ForgeMotion/Electronics/SF Electronics V1.1.jpg

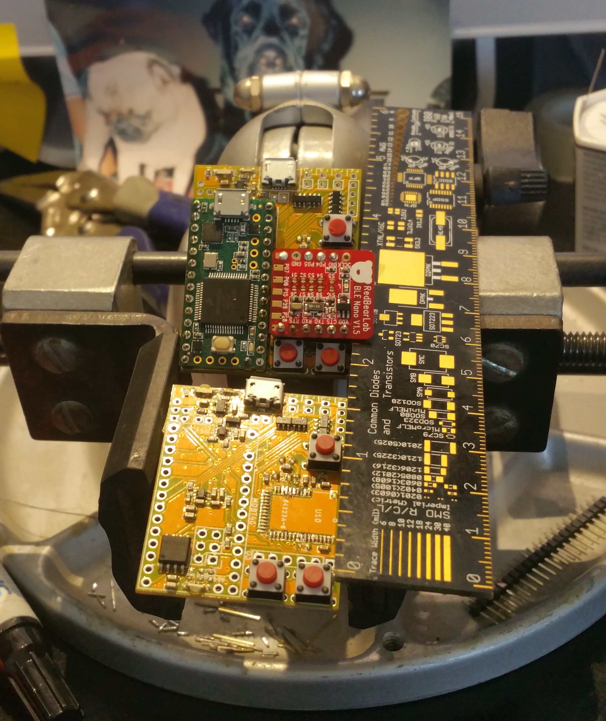
SF Electronics V1.1.jpg
