ForgeMotion/Electronics/SF Electronics V1.1 vs Mega.jpg

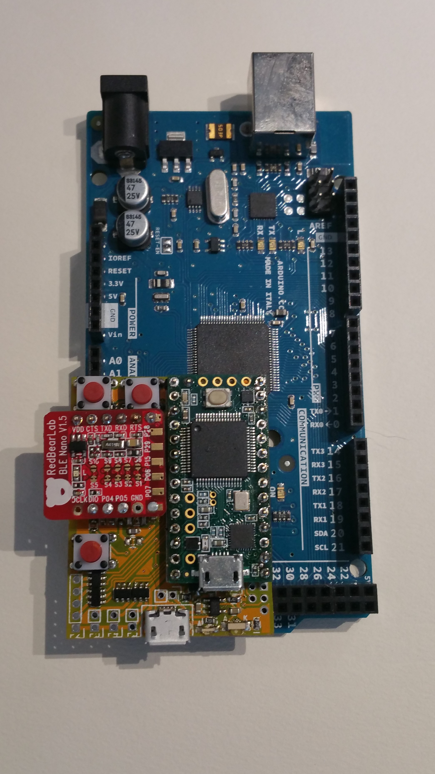
SF Electronics V1.1 vs Mega.jpg
