ForgeMotion/Electronics/Mainboard/Swing Forge V2 Mainboard.png

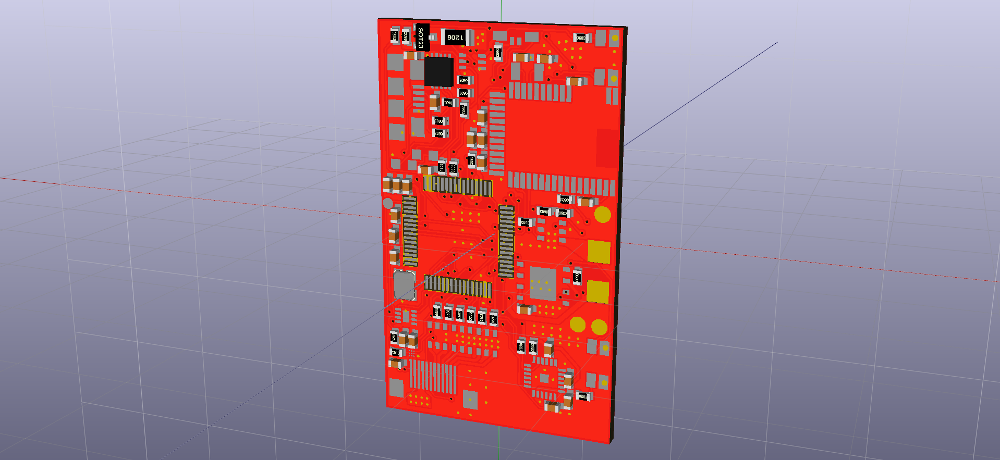
Mainboard/Swing Forge V2 Mainboard.png
