ForgeMotion/Electronics/Reference/BLE Nano Pinout Numbered.png

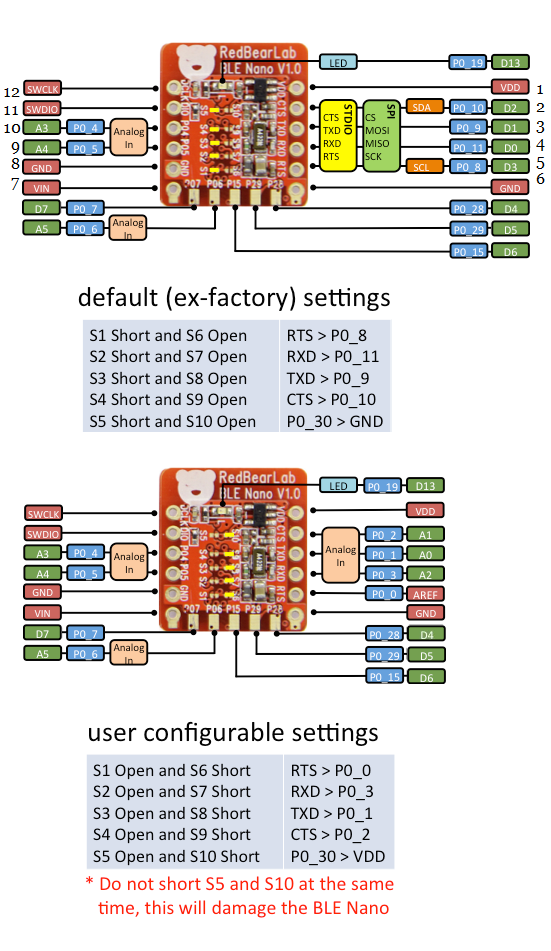
Reference/BLE Nano Pinout Numbered.png
