ForgeMotion/Electronics/Reference/Redbear pinout consolidated.jpg

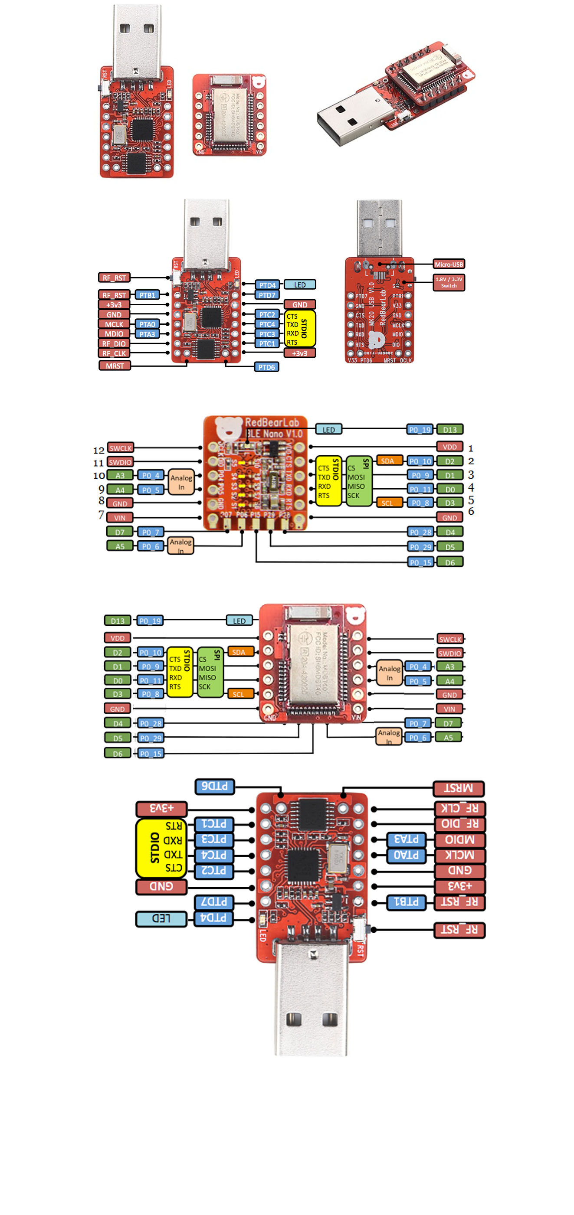
Reference/Redbear pinout consolidated.jpg
