ForgeMotion/Electronics/Reference/Soft latch power switch toggle.PNG

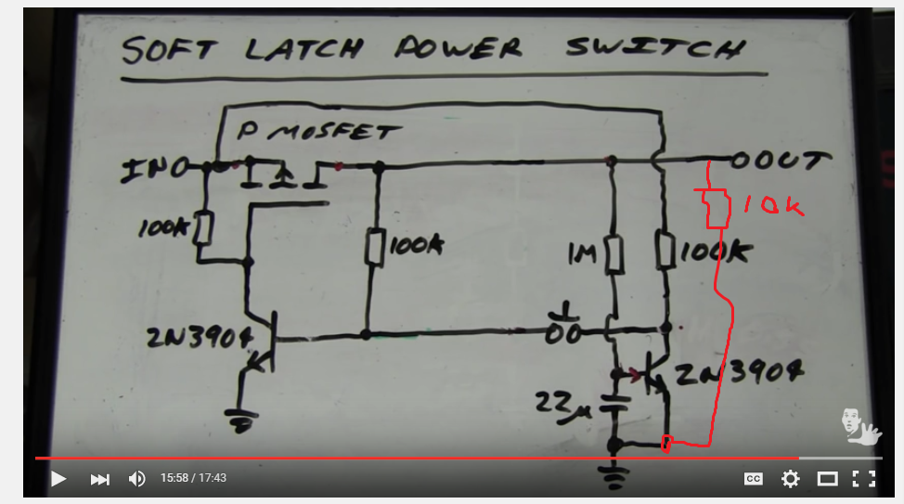
Reference/Soft latch power switch toggle.PNG
