ForgeMotion/Electronics/SF Electronics V1.1 no proc annotated.jpg

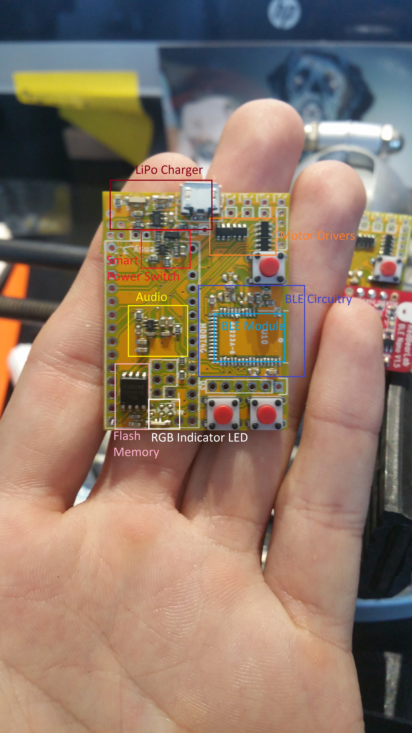
SF Electronics V1.1 no proc annotated.jpg
