ForgeMotion/Electronics/BOM estimation.xlsx

Number of boards | Reference | Description | Quantity per board | Order Quantity | Footprint | Mfg Name | Mfg Part Number | Mouser Part Number | Suggested Replacement | Price 1 | Min\Mult Order Qty | Line price | Line price per board
1000 | U7 | BLE 4.1 Module NRF51822 | 1 | 1000 | MDBT40:MDBT40 | Raytac | MDBT40 |  |  | $7.50 |  | $7500.00 | $7.50
 | U1 | ARM Microcontrollers - MCU ARM Microcontrollers - MCU KINETIS 256K | 1 | 1000 | MK20DX256VLH7:QFP50P1200X1200X160-64N | NXP | MK20DX256VLH7 | 841-MK20DX256VLH7 |  | $4.37 | 1\1 | $4370.00 | $4.37
 | U8 | MPU-6050 | 1 | 1000 | Sensors_Custom:MPU-6050_QFN-24 | Invensense | MPU-6050 | 1428-1007-1-ND |  | $4.05 |  | $4050.00 | $4.05
 | U2 | 128MB SPI Flash | 1 | 1000 | SparkFun-Sensors:SO08WIDE | Winbond Electronics | W25Q128FVSIG | W25Q128FVSIG-ND |  | $1.13 |  | $1130.97 | $1.13
 | U10 | MOSFET MOSFET 650mW 20V | 4 | 4000 | SOT_Custom:SOT-26 | Diodes Incorporated | DMN2215UDM-7 | 621-DMN2215UDM-7 |  | $0.174 | 1\1 | $696.00 | $0.70
 | U5 | Digital Potentiometer ICs Digital Potentiometer ICs Sgl 256-tap Volatile DigiPot w/SPI | 1 | 1000 | SparkFun-PowerIC:TDFN-8 | Maxim Integrated | MAX5395LATA+T | 700-MAX5395LATA+T |  | $0.648 | 1\1 | $648.00 | $0.65
 | SW1 | Tactile Switches Tactile Switches | 3 | 3000 | Switches_Custom:PTS840_PK_alt_2pin | C&K Components | PTS840 PK SMTR LFS | 611-PTS840PKSMTR |  | $0.17 | 1\1 | $510.00 | $0.51
 | P1 | FFC & FPC Connectors FFC & FPC Connectors ZIF FPC 0.5, 2H, 10P | 1 | 1000 | Connectors_Custom:TE_1-1775333-0_FPC_Socket_10pin | TE Connectivity | 1-1775333-0 | 571-1-1775333-0 |  | $0.48 | 20000\20000 | $480.00 | $0.48
 | U3 | Battery Management Battery Management Charge mgnt contr | 1 | 1000 | SparkFun-DigitalIC:SOT23-5 | Microchip | MCP73831T-2ACI/OT | 579-MCP73831T-2ACIOT |  | $0.42 | 1\1 | $420.00 | $0.42
 | P2 | USB Connectors USB Connectors uUSB B Rec BotMt Flangeless SMT | 1 | 1000 | open-project:MICRO-B_USB | Molex | 47346-1001 | 538-47346-1001 |  | $0.409 | 1\1 | $409.00 | $0.41
 | U6 | Audio Amplifiers Audio Amplifiers Speaker Amplifier | 1 | 1000 | Audio_Amplifiers_Custom:MAX38309 | Maxim Integrated | MAX98310EWL+T | 700-MAX98310EWL+T |  | $0.385 | 1\1 | $385.00 | $0.39
 | X2 | Crystals Crystals 32.768kHz AECQ200 9pF 20ppm -40cC +85C | 1 | 1000 | Crystal_Custom:ABS07AIG | ABRACON | ABS07AIG-32.768kHz-9-D-T | 815-S07AIG-32.7689DT |  | $0.339 | 1\1 | $339.00 | $0.34
 | X1 | Crystals 16MHz 10ppm 9pF -20C +75C | 1 | 1000 | Crystals:crystal_FA238-TSX3225 | Epson Timing | TSX-3225 16.0000MF09Z-AC3 | 732-TX325-16F09Z-AC3 |  | $0.27 |  | $272.00 | $0.27
 | Q1 | MOSFET MOSFET P-CHANNEL ENHANCEMENT MODE | 1 | 1000 | TO_SOT_Packages_SMD:SOT-23 | Diodes Incorporated | DMG3415U-7 | 621-DMG3415U-7 |  | $0.17 | 1\1 | $170.00 | $0.17
 | D1 | Standard LEDs - SMD Standard LEDs - SMD SMD LED Side Look Red/Green/Blue | 1 | 1000 | LEDS_SMD_Custom:LTST-S310 | Lite-On | LTST-S310F2KT | 859-LTST-S310F2KT |  | $0.168 | 1\1 | $168.00 | $0.17
 | U4 | LDO Voltage Regulators LDO Voltage Regulators FAST TRANSIENT RESPO | 1 | 1000 | Regulators_Custom:XDFN4_1x1mm_for_NCP177 | ON Semiconductor | NCP177AMX330TCG | 863-NCP177AMX330TCG |  | $0.104 | 1\1 | $104.00 | $0.10
 | L1 | Fixed Inductors Fixed Inductors 10uH 10% | 1 | 1000 | Capacitors_SMD:C_0603 | Vishay | 70-ILSB0603RK100K | 70-ILSB0603RK100K |  | $0.088 | 1\1 | $88.00 | $0.09
 | D2 | Standard LEDs - SMD Standard LEDs - SMD Red Clear 631nm | 1 | 1000 | LEDS_SMD_Custom:LTST-S270 | Lite-On | LTST-S270KRKT | 859-LTST-S270KRKT |  | $0.057 | 1\1 | $57.00 | $0.06
 | D3 | Standard LEDs - SMD Standard LEDs - SMD Green Clear 571nm | 1 | 1000 | LEDS_SMD_Custom:LTST-S270 | Lite-On | LTST-S270KGKT | 859-LTST-S270KGKT |  | $0.057 | 1\1 | $57.00 | $0.06
 | Q2 | Bipolar Transistors - BJT Bipolar Transistors - BJT 600mA 75V Dual NPN | 1 | 1000 | SOT_Custom:SOT-363 | ON Semiconductor | MBT2222ADW1T1G | 863-MBT2222ADW1T1G |  | $0.044 | 1\1 | $44.00 | $0.04
 | L2 | Fixed Inductors Fixed Inductors 15nH 10% | 1 | 1000 | Capacitors_SMD:C_0603 | Johanson | L-14C15NKV4T | 609-L-14C15NKV4T |  | $0.02 | 1\1 | $20.00 | $0.02
 | BT1 | 1S 1000mAh Lipo battery | 1 | 1000 | Pin_Headers_github:Pin_Header_Straight_1x02_Pitch2.00mm |  |  |  |  | $0.00 |  | $0.00 | $0.00
 |  |  |  |  |  |  |  |  |  |  |  | $21917.97
 |  |  |  |  |  |  |  |  |  |  |  | $21.92
 |  |  |  |  |  |  |  |  |  | Changes
 |  |  |  |  |  |  |  |  |  |  | Remove 1 switch | -0.17
 |  |  |  |  |  |  |  |  |  |  | 128MB->64MB flash | -0.60747
 |  |  |  |  |  |  |  |  |  |  | Get MDBT40 quote | -4
 |  |  |  |  |  |  |  |  |  |  | New audio | 0.1
 |  |  |  |  |  |  |  |  |  |  | Faster charging |  | 0.5
 |  |  |  |  |  |  |  |  |  |  | Remove BJT | -0.04
 |  |  |  |  |  |  |  |  |  |  | Internal LDO | -0.1
 |  |  |  |  |  |  |  |  |  |  | Ali MPU-6050 | -1.55
 |  |  |  |  |  |  |  |  |  |  | Ali Battery | -1
 |  |  |  |  |  |  |  |  |  |  | New USB conn |  | -0.2
 |  |  |  |  |  |  |  |  |  |  | New total | $14.55
