ForgeMotion/Electronics/Power consumption testing.xlsx

teensy | 18.5 | mA
audio | 3 | W
 | 909.0909091 | mA |  | Peak 3.3V current consumption
 |  |  |  | 116.4 | *Does not include audio! Run from battery and try to compensate for battery voltage with volume control!
rgb | 60 | mA |  | 349.2
motors | 7
 | 100 | mA
BLE
TX | 6 to 16 | mA | for -30 to +4 dBm
RX | 13 | mA
mpu6050
standby | 5 | uA
operating | 3.9 | mA
SPI flash
standby | 1 | uA
operating | 4 | mA |  | 400 | mAh
 |  |  |  | 1440000 | mAs
 |  |  | per swing | 30 | s
 |  |  | motors | 50% |  | of time
 |  |  |  | 10500 | mAs
 |  |  | mpu6050 | 117 | mAs
 |  |  | SPI flash | 120 | mAs
 |  |  | Audio | 1 | s
 |  |  |  | 810.8108108 | mAs
 |  |  |  | 11547.81081 | mAs | per swing
 |  |  | at boot
 |  |  | Audio | 20 | s
 |  |  |  | 16216.21622 | mAs
 |  |  | mpu6050 | 58.5 | mAs
 |  |  | motors | 30 | s
 |  |  |  | 21000 | mAs
 |  |  | BLE | 30 | s
 |  |  |  | 480 | mAs
 |  |  |  | 37754.71622 | mAs | per boot
 |  |  | idle power
 |  |  |  | 0.2 | mA
 |  |  | regular operation
 |  |  | 1 | boot
 |  |  | 90 | swings per hour
 |  |  | 900 | seconds of idle/hour
 |  | boot | 37754.71622 | mAs
 |  | idle/hour | 180 | mAs
 |  | swing/hour | 1039302.973 | mAs
 |  |  | 4 | hours
 |  |  | 4195686.608 | mAs
 |  |  | 1165.468502 | mAh
 |  |  | 1000 | mAh
 |  |  | 3600000 | mAs
 |  |  | 3.426939523 | hours
