ForgeMotion/Electronics/Red PCB 1 Testpoint locations.PNG

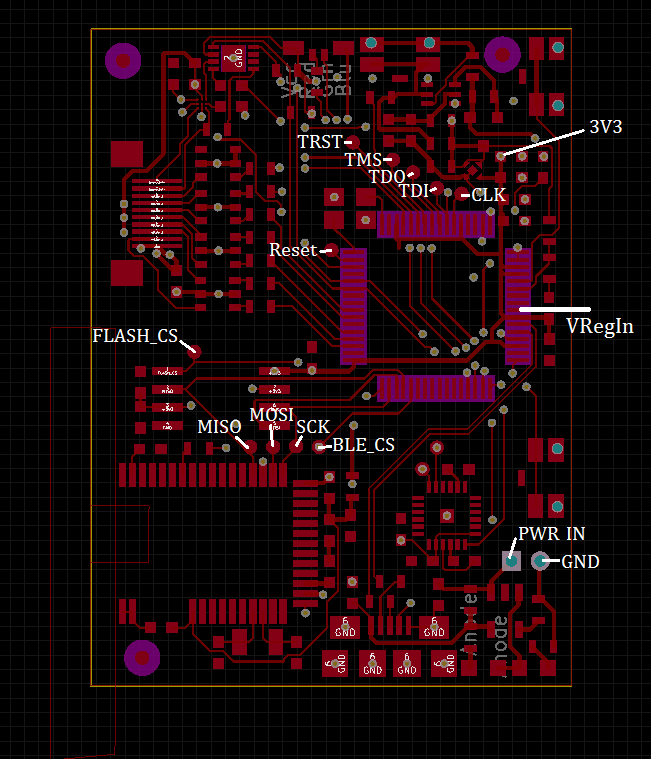
Red PCB 1 Testpoint locations.PNG
