ForgeMotion/Electronics/(threads)

Thread 3 (2018-01-09):

Move therm pin to reduce risk of shorts in production

TMcGahee, 2018-01-09:
