ForgeMotion/Electronics/Distroboard/Distroboard Schematic V1.0.pdf

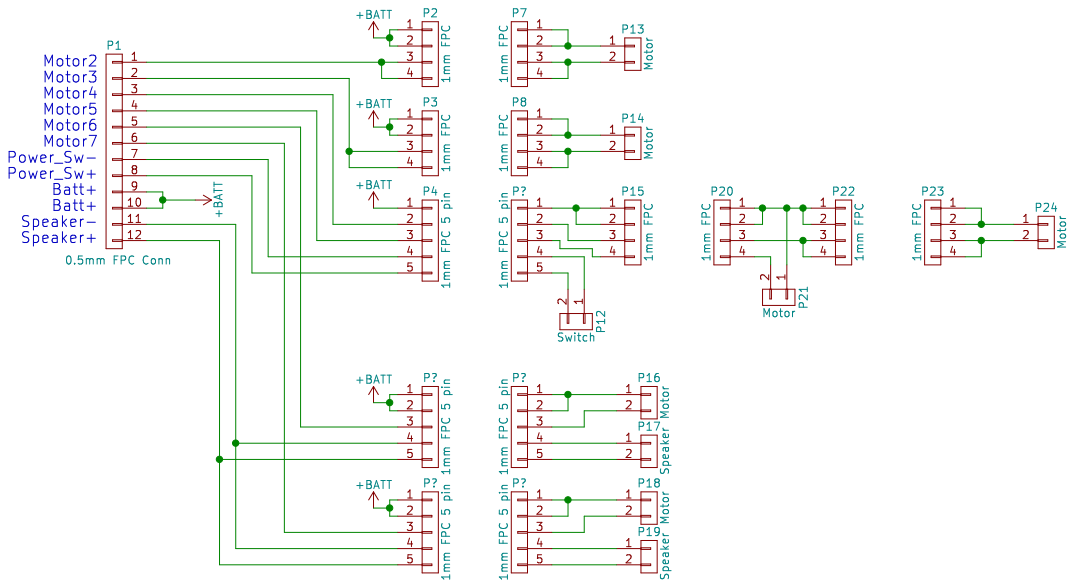
[picture p9: page 1]
