ForgeMotion/Electronics/Mainboard/Swing Forge Schematic 4.2.pdf

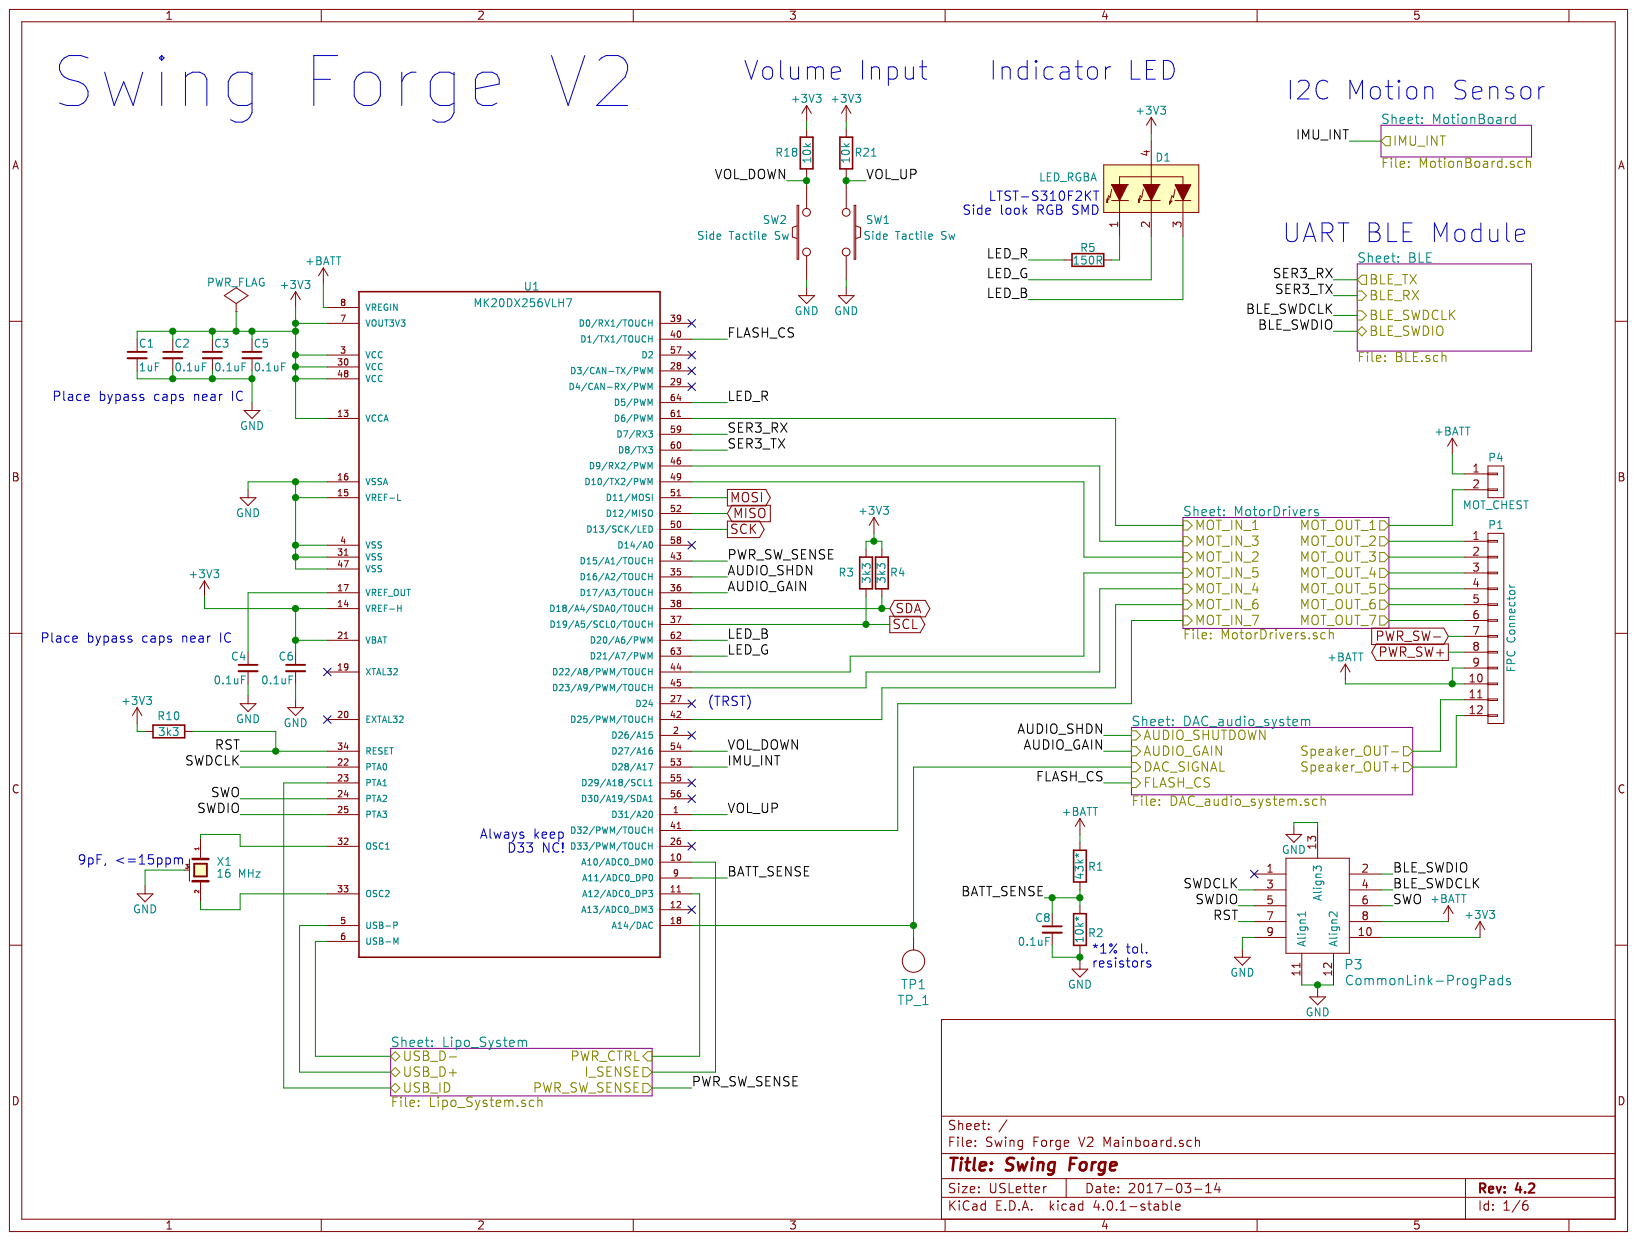
[picture p10: page 1]

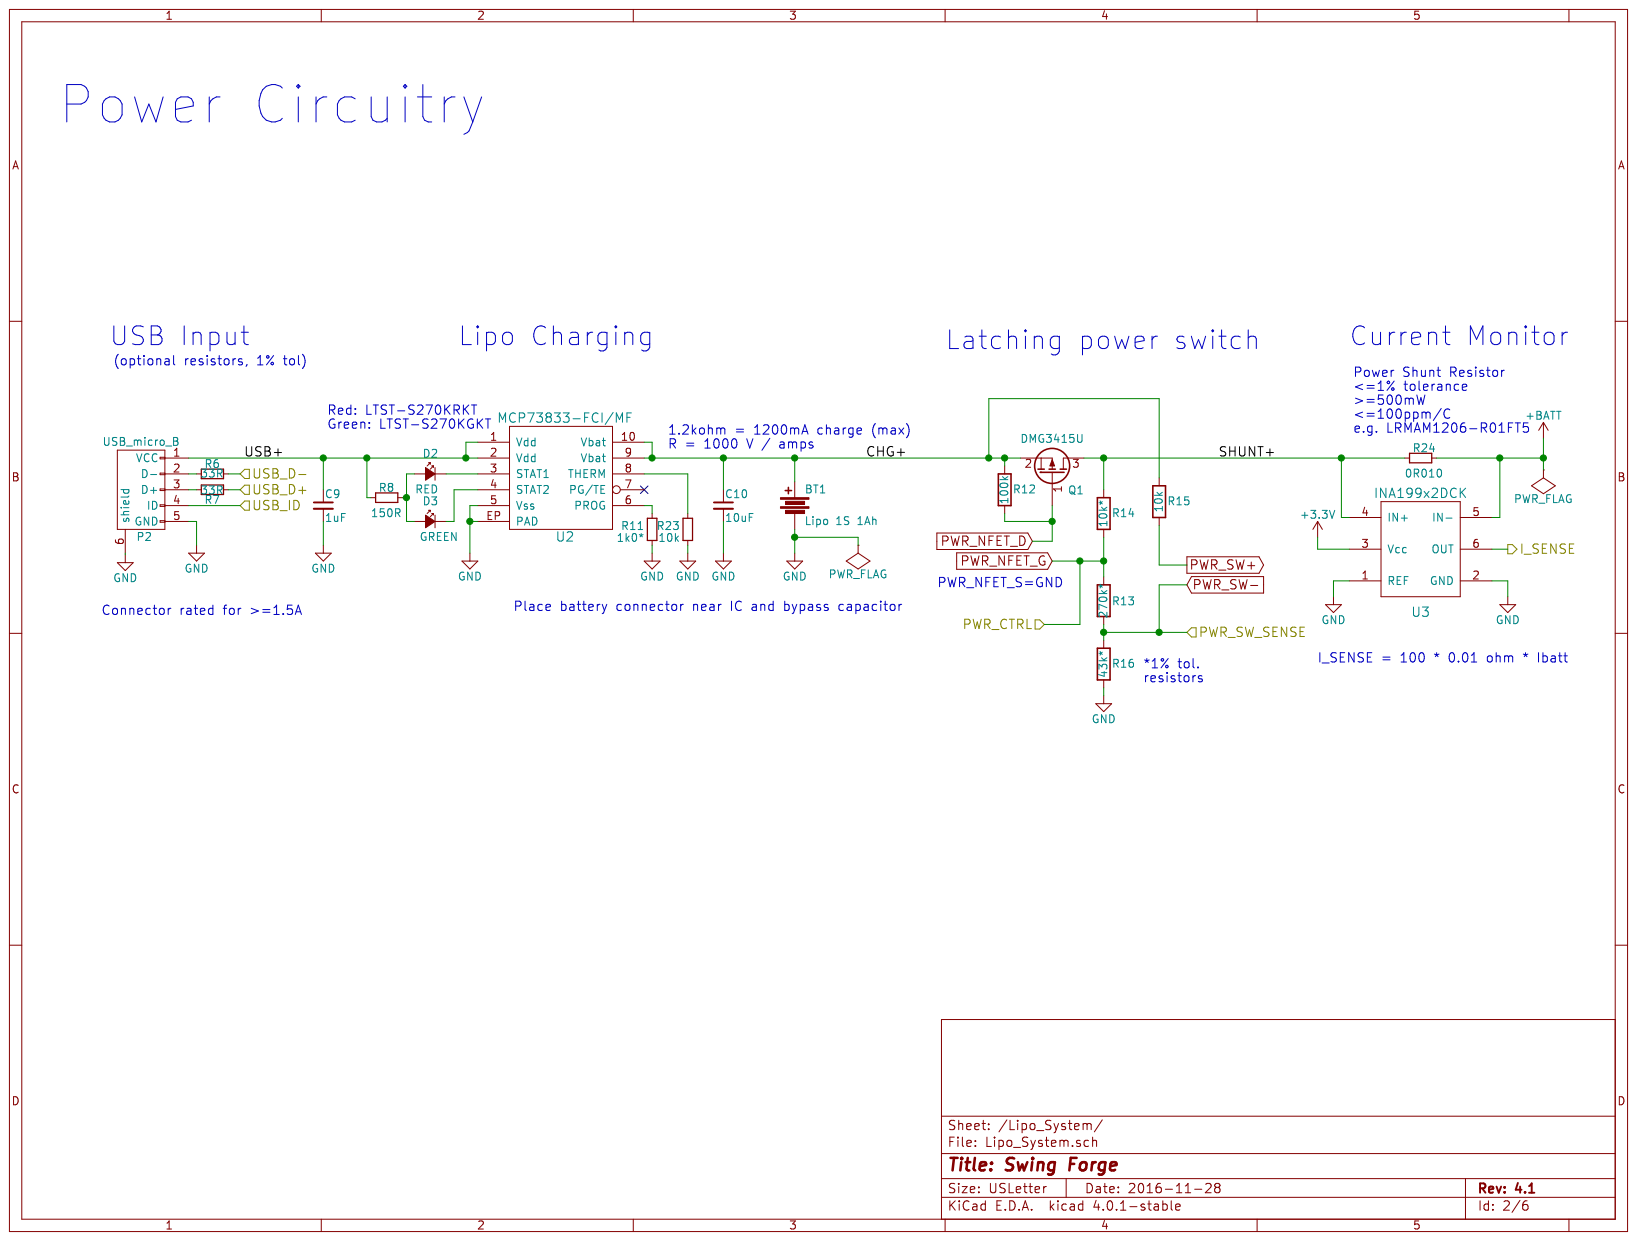
[picture p11: page 2]

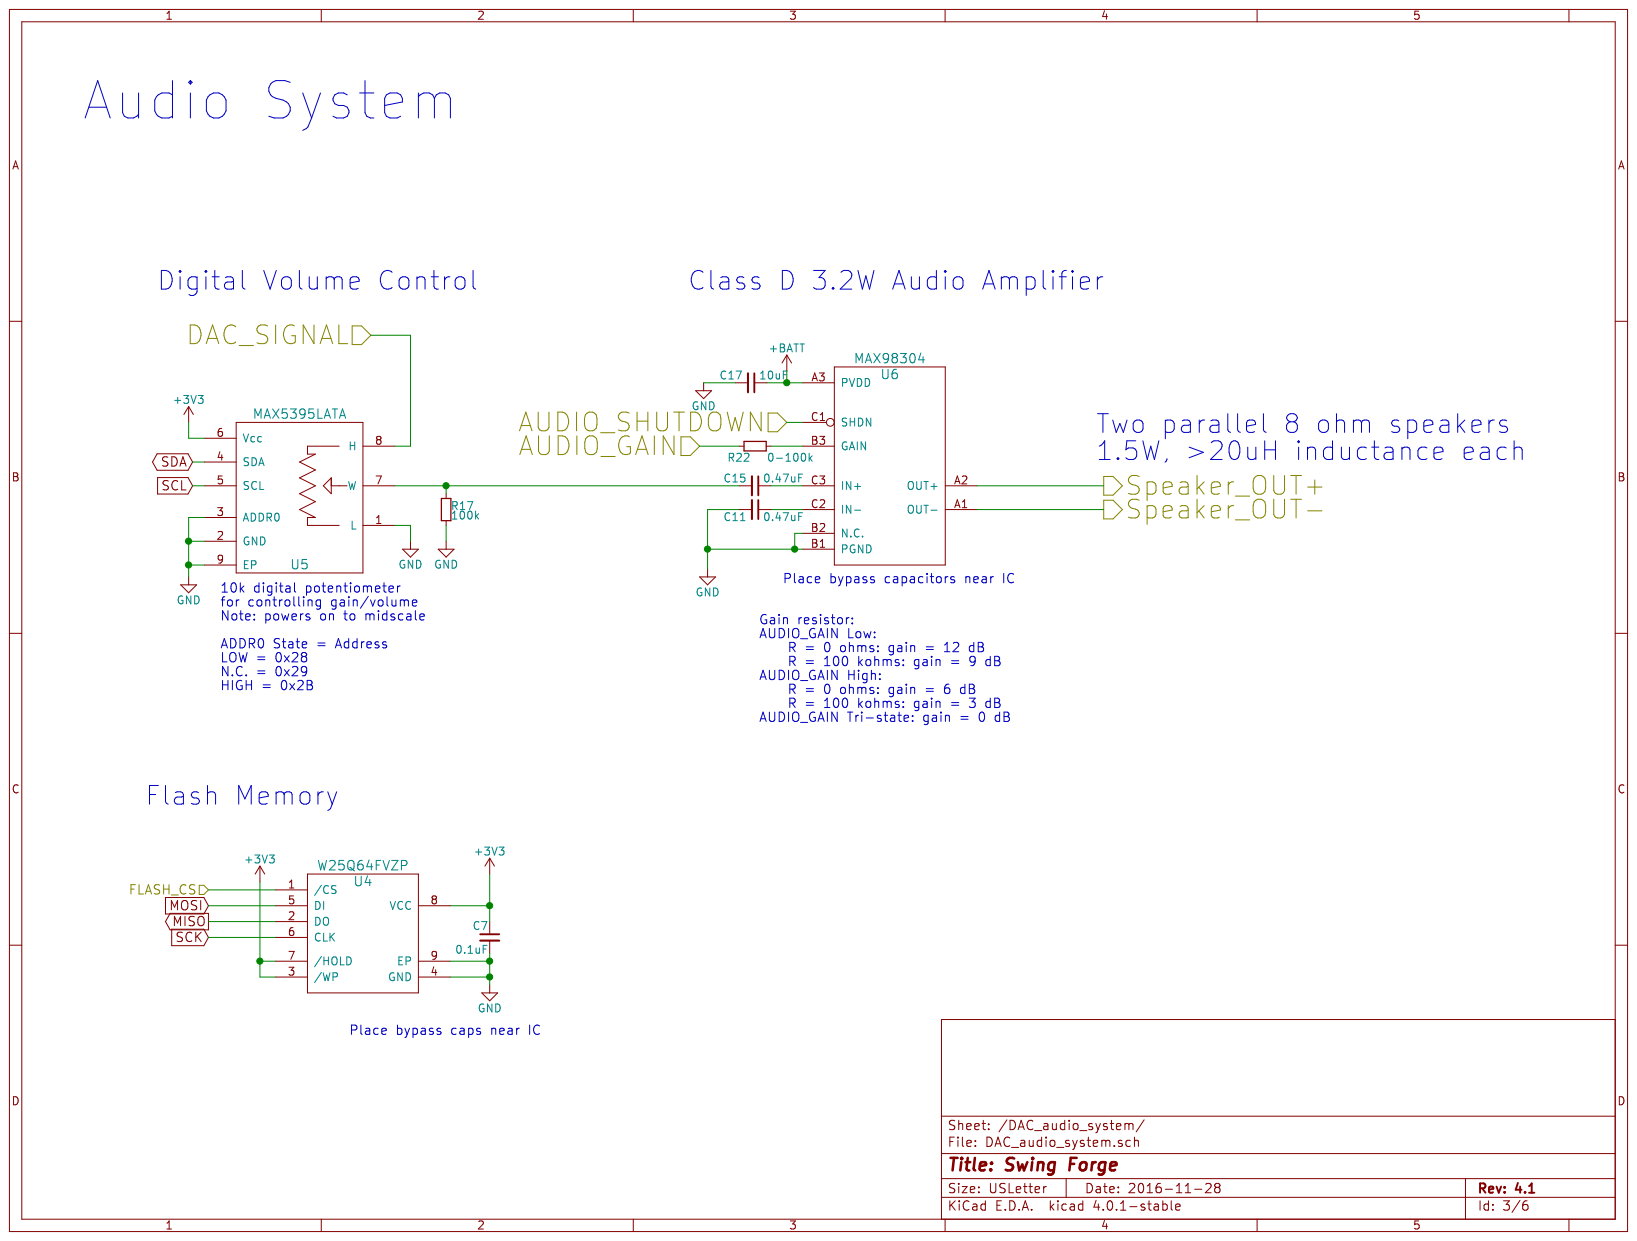
[picture p12: page 3]

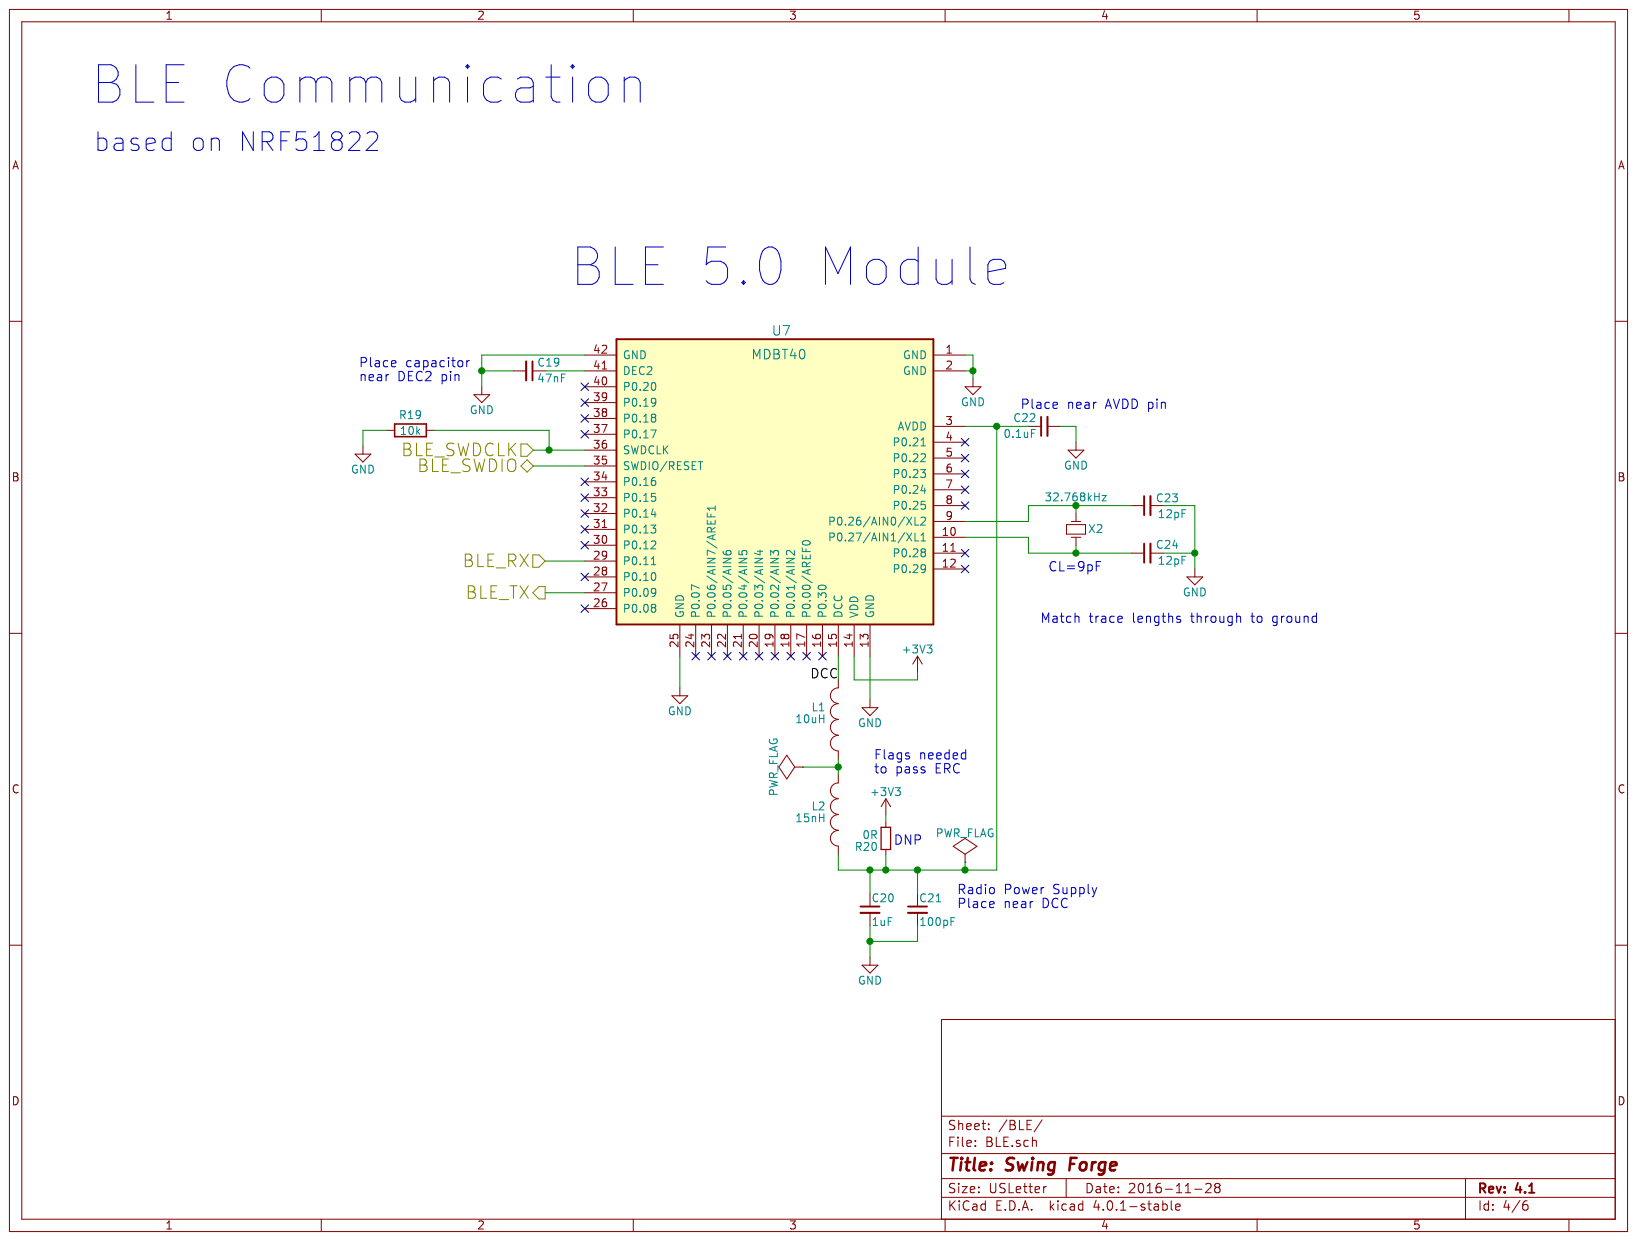
[picture p13: page 4]

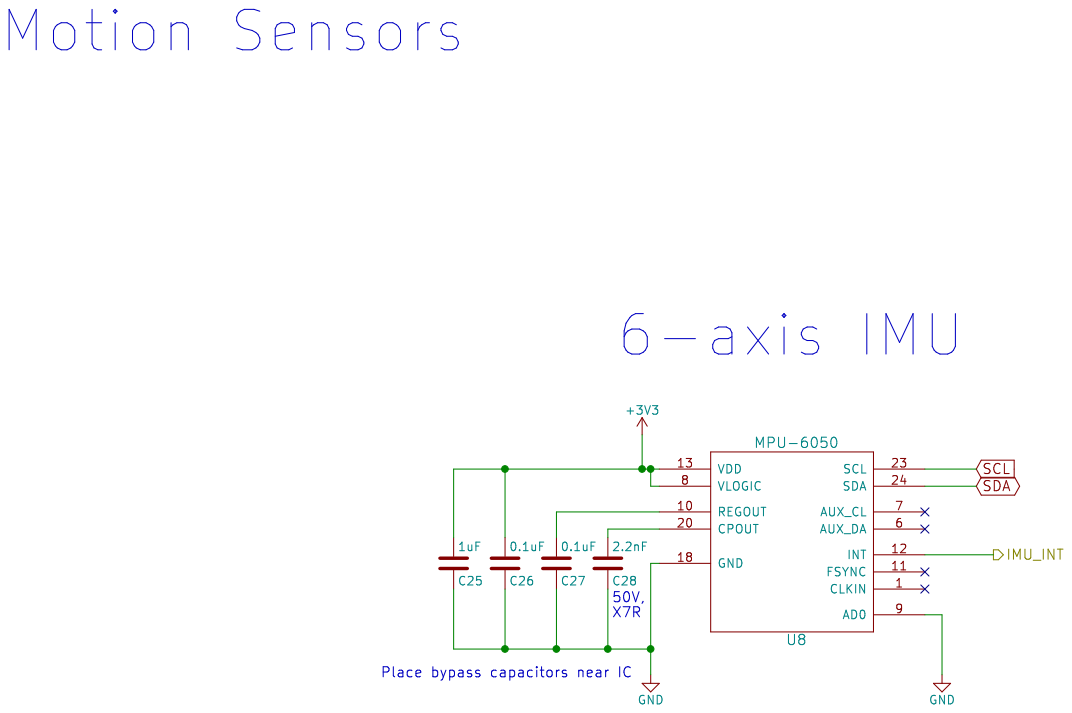
[picture p14: page 5]

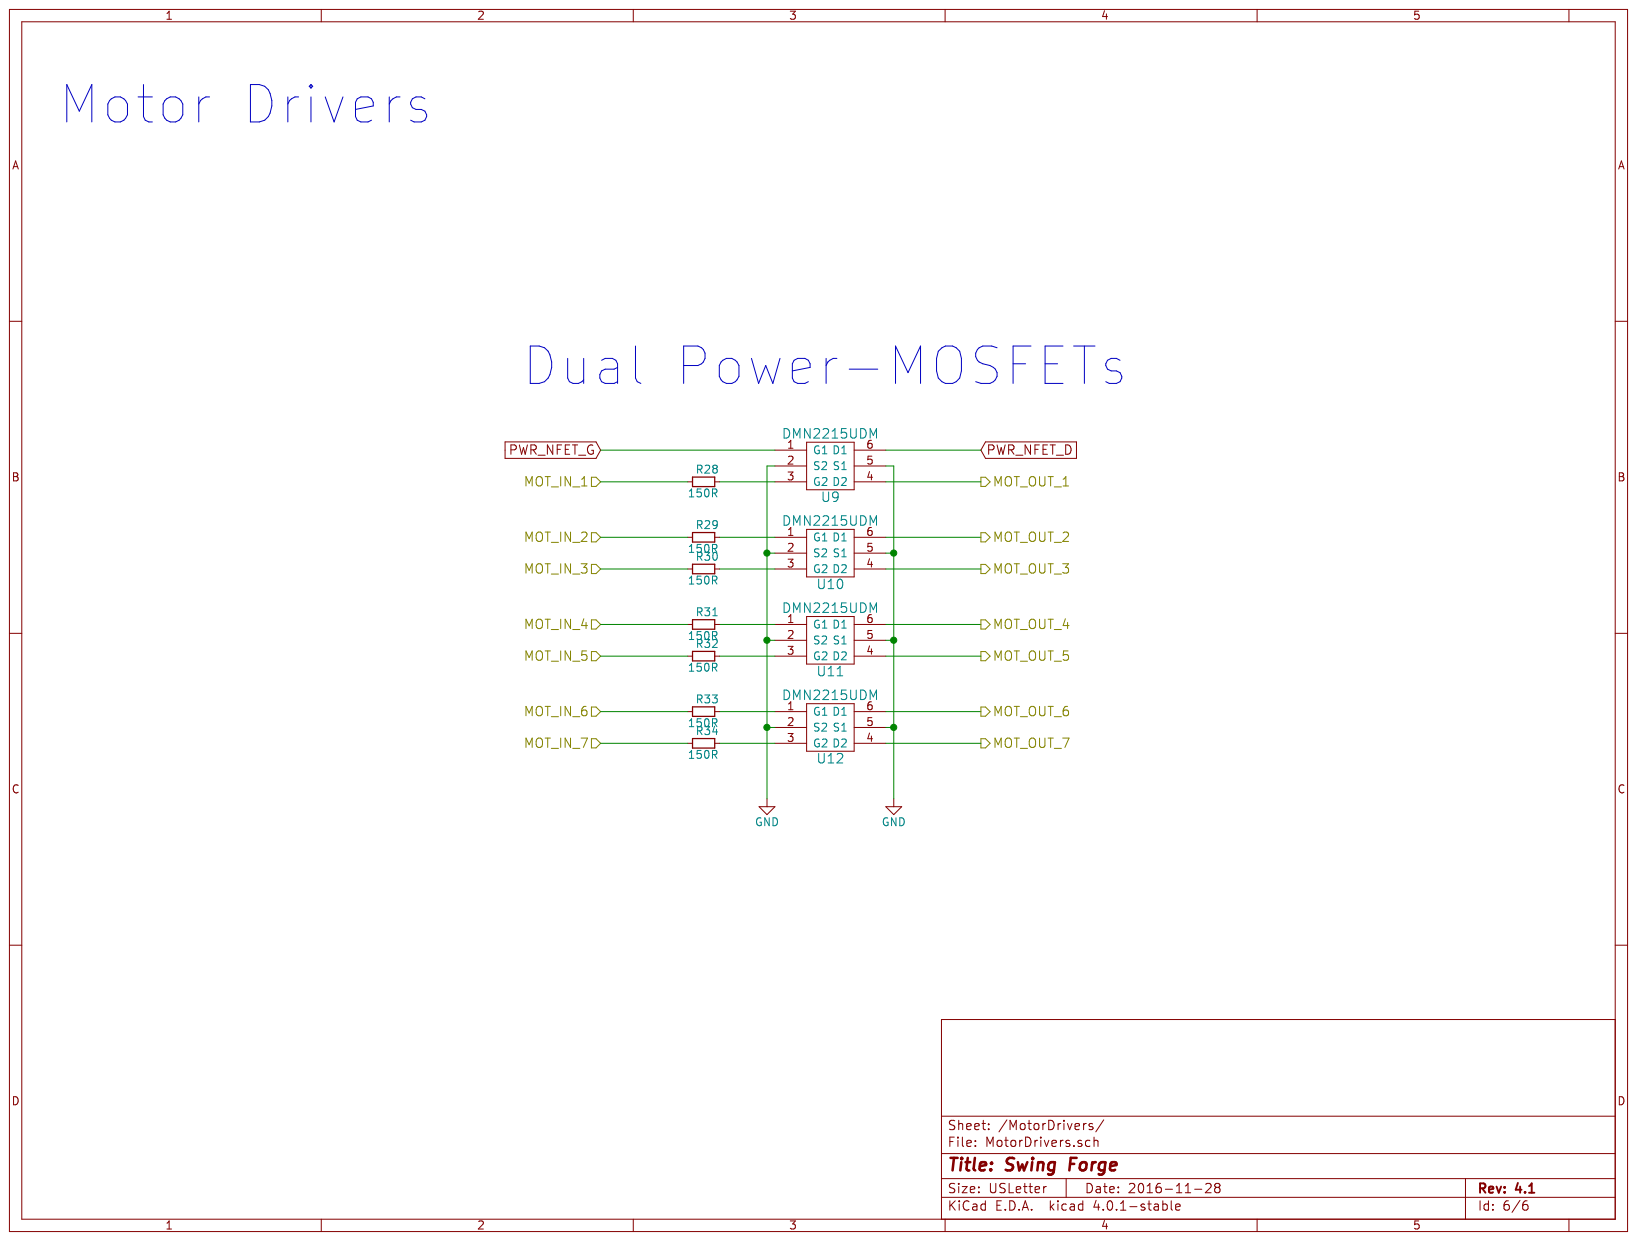
[picture p15: page 6]
