ForgeMotion/Electronics/(list of files, drawings)

Other design files:
Mainboard/Swing Forge V2 Mainboard.dsn
