ForgeMotion/Electronics/Distroboard/Distroboard.kicad_pcb

## KiCad design swift-caller-hardware/swift-caller-hardware.kicad_sch

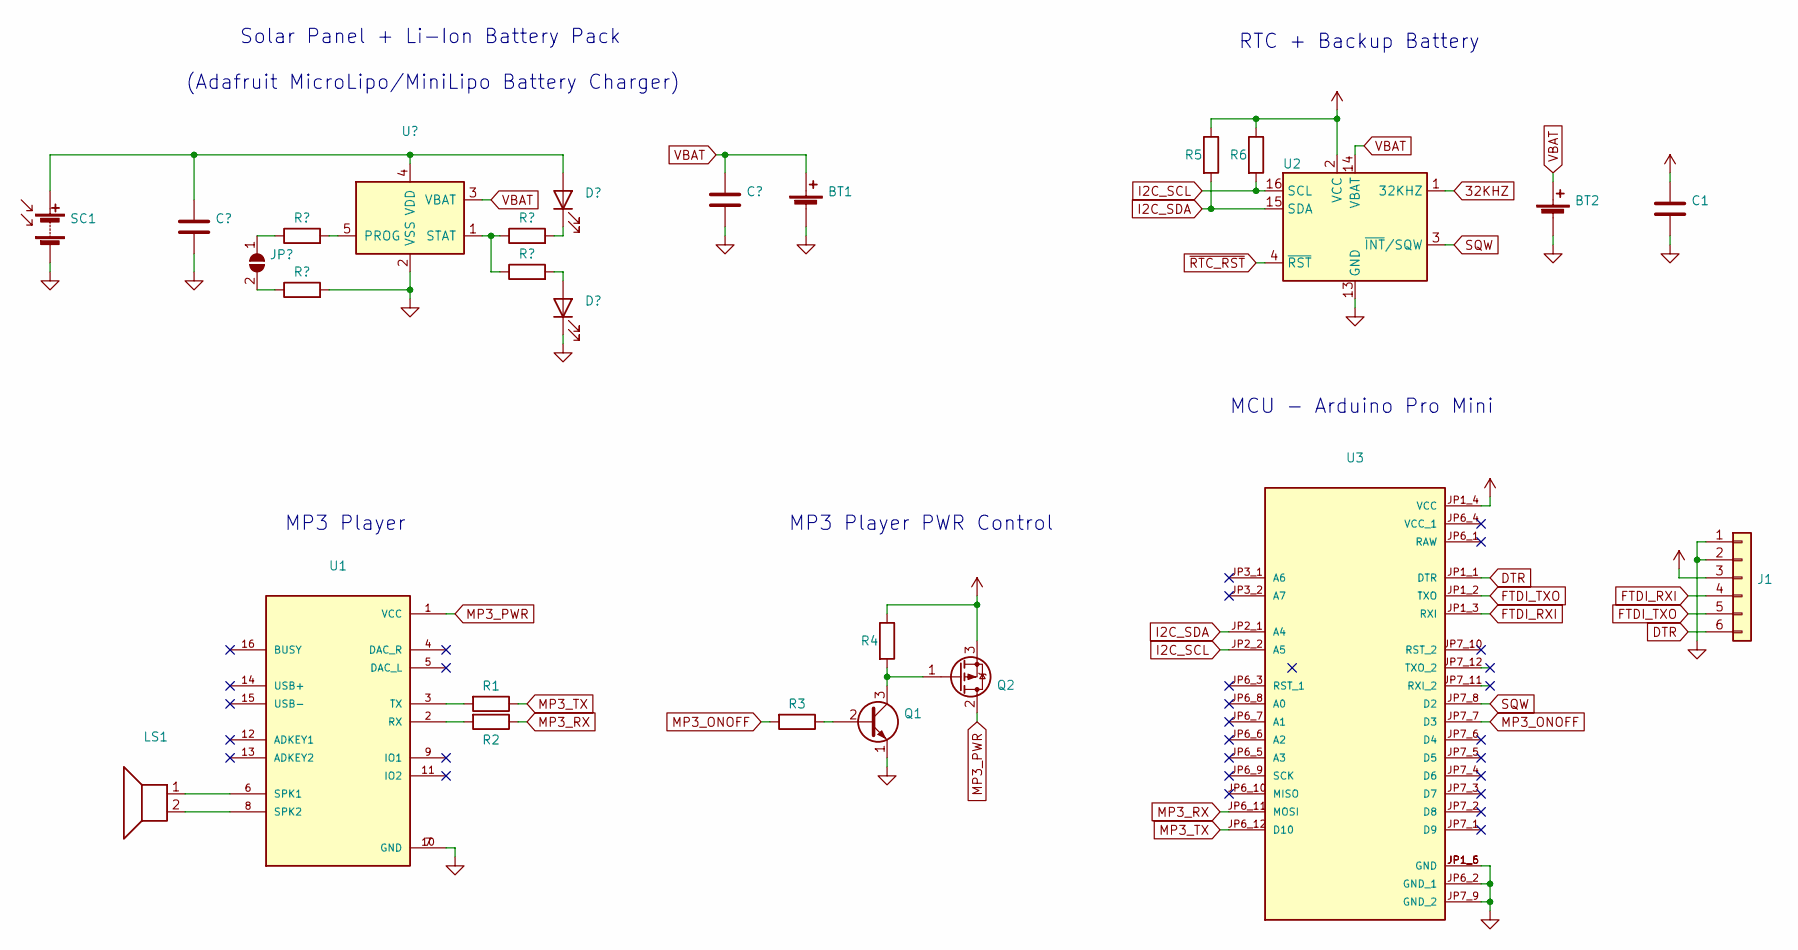
[picture p16: schematic swift-caller-hardware.kicad_sch]

Parts:
BT1, BT2: (no value)
C1: (no value)
J1: (no value)
LS1: (no value)
Q1, Q2: (no value)
R1, R2, R3, R4, R5, R6: (no value)
SC1: (no value)
U1, U2: (no value)
U3: PARTREV N/A

Connections:
32KHZ: U2.1 (32KHZ)
DTR: J1.6, U3.JP1_1 (DTR)
FTDI_RXI: J1.4, U3.JP1_3 (RXI)
FTDI_TXO: J1.5, U3.JP1_2 (TXO)
I2C_SCL: R6.2, U2.16 (SCL), U3.JP2_2 (A5)
I2C_SDA: R5.2, U2.15 (SDA), U3.JP2_1 (A4)
MP3_ONOFF: R3.2, U3.JP7_7 (D3)
MP3_PWR: Q2.2 (D), U1.1 (VCC)
MP3_RX: R2.1, U3.JP6_11 (MOSI)
MP3_TX: R1.1, U3.JP6_12 (D10)
unnamed: BT2.2 (-), C1.1, C1.2, J1.1, J1.2, J1.3, Q1.1 (E), Q2.3 (S), R4.1, R5.1, R6.1, SC1.2 (-), U1.7 (GND), U1.10 (GND), U2.2 (VCC), U2.5 (GND), U2.6 (GND), U2.7 (GND), U2.8 (GND), U2.9 (GND), U2.10 (GND), U2.11 (GND), U2.12 (GND), U2.13 (GND), U3.JP1_4 (VCC), U3.JP1_5 (GND), U3.JP1_6 (GND), U3.JP6_2 (GND_1), U3.JP7_9 (GND_2)
unnamed: LS1.1, U1.6 (SPK1)
unnamed: LS1.2, U1.8 (SPK2)
unnamed: Q1.2 (B), R3.1
unnamed: Q1.3 (C), Q2.1 (G), R4.2
unnamed: R1.2, U1.3 (TX)
unnamed: R2.2, U1.2 (RX)
SQW: U2.3 (~INT/SQW), U3.JP7_8 (D2)
VBAT: BT1.1 (+), BT2.1 (+), U2.14 (VBAT)
~RTC_RST: U2.4 (~RST)

Notes on the sheet:
MCU - Arduino Pro Mini
RTC + Backup Battery
MP3 Player
MP3 Player PWR Control
(Adafruit MicroLipo/MiniLipo Battery Charger)
Solar Panel + Li-Ion Battery Pack
