ForgeMotion/Electronics/(commit log)

2018-01-03 Initial commit of 10.0
    [Audio attenuator digipot calculations.xlsx, BLE.sch, BOM estimation.xlsx, DAC_audio_system.sch, FlashMemory.sch, Lipo Charger 1A MCP7383x calculations and part numbers.xlsx, Lipo_System.sch, MotionBoard.sch]
2018-01-16 Distroboard - schematic finished, PCB in progress
    [Distroboard.kicad_pcb, Distroboard.sch]
